freecores/pci/apps/README.txt

This directory contains actual applications provided for testing or developing pci bridge core.
- crt - a simple crt controller which uses master interface to fetch pixel data from system memory
