freecores/pci/(commit log)

2004-03-19 Single PCI Master write fix.
    [bus_commands.v, crtc_iob.v, i2c_slave_model.v, pci_async_reset_flop.v, pci_behavioral_pci2pci_bridge.v, pci_behaviorial_device.v, pci_behaviorial_master.v, pci_behaviorial_target.v]
2004-07-07 Added SubsystemVendorID, SubsystemID, MAXLatency, MinGnt defines. Enabled value loading from serial EEPROM for all of the above + VendorID and DeviceID registers.
2004-08-19 Changed minimum pci image size to 256 bytes because of some PC system problems with size of IO images.
    [pci_bridge32.v, pci_conf_space.v, pci_pci_tpram.v, pci_regression_constants.v, pci_target32_interface.v, pci_target_unit.v, pci_user_constants.v, pci_wb_tpram.v]
