freecores/pci/(notices)

Notices in the files:
rtl/verilog/pci_spoci_ctrl.v:
Copyright (C) 2004 Miha Dolenc, mihad@opencores.org
Public License as published by the Free Software Foundation;
Public License along with this source; if not, download it
from http://www.opencores.org/lgpl.shtml
rtl/verilog/pci_conf_space.v:
Copyright (C) 2000 Tadej Markovic, tadej@opencores.org
rtl/verilog/pci_wb_slave_unit.v:
Copyright (C) 2001 Miha Dolenc, mihad@opencores.org
apps/crt/rtl/verilog/ssvga_top.v:
Copyright (C) 2000 Authors and OPENCORES.ORG
bench/verilog/pci_behaviorial_target.v:
under the terms of the GNU Lesser General Public License as published
